claytonlittle/stemcells/(commit log)

2016-08-03 Added GUI and washing to pump code
2016-08-16 manual sync for tkinter error
    [fluidmaster.py]
